bileki/CarPuter/Images/IMG_20160610_152235857_HDR.jpg

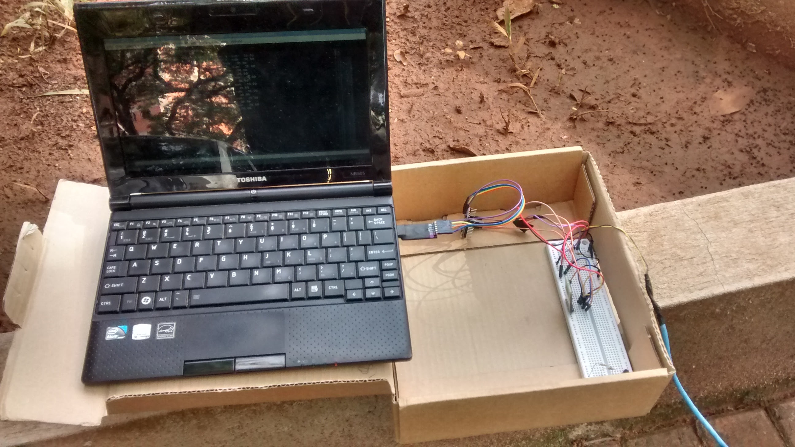
Images/IMG_20160610_152235857_HDR.jpg
