bileki/CarPuter/Images/IMG_20160610_152221243.jpg

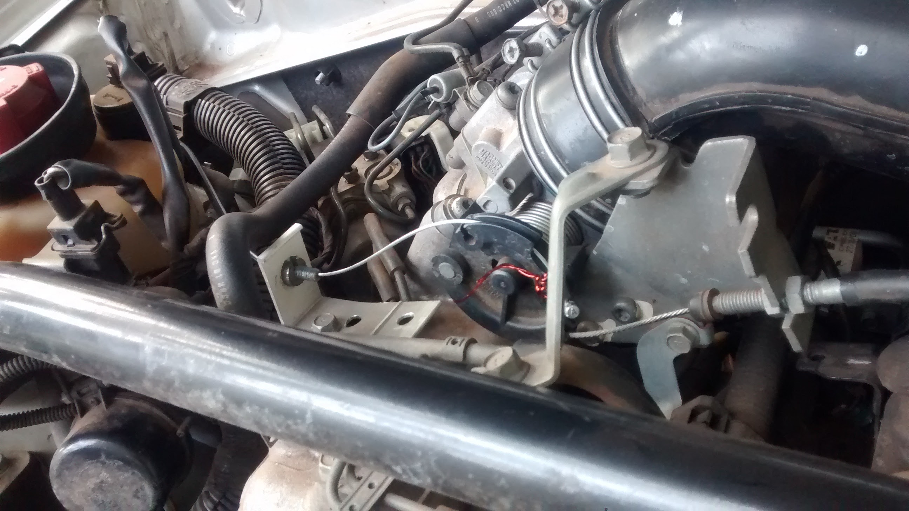
Images/IMG_20160610_152221243.jpg
