bileki/CarPuter/Images/IMG_20160420_165813343.jpg

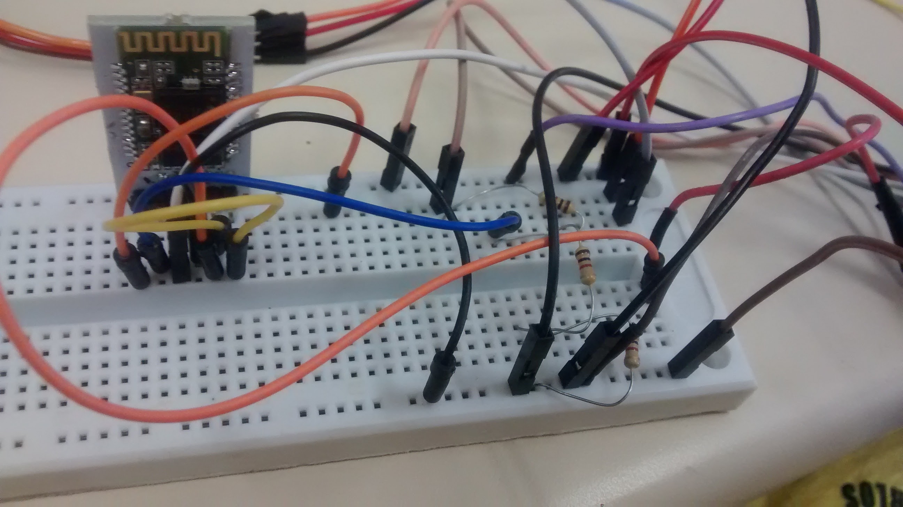
Images/IMG_20160420_165813343.jpg
