bileki/CarPuter/Images/IMG_20160420_165830831.jpg

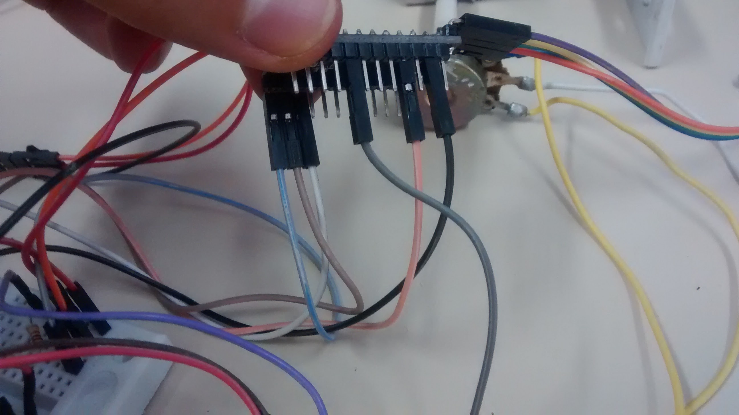
Images/IMG_20160420_165830831.jpg
