bileki/CarPuter/Images/IMG_20160420_165851657.jpg

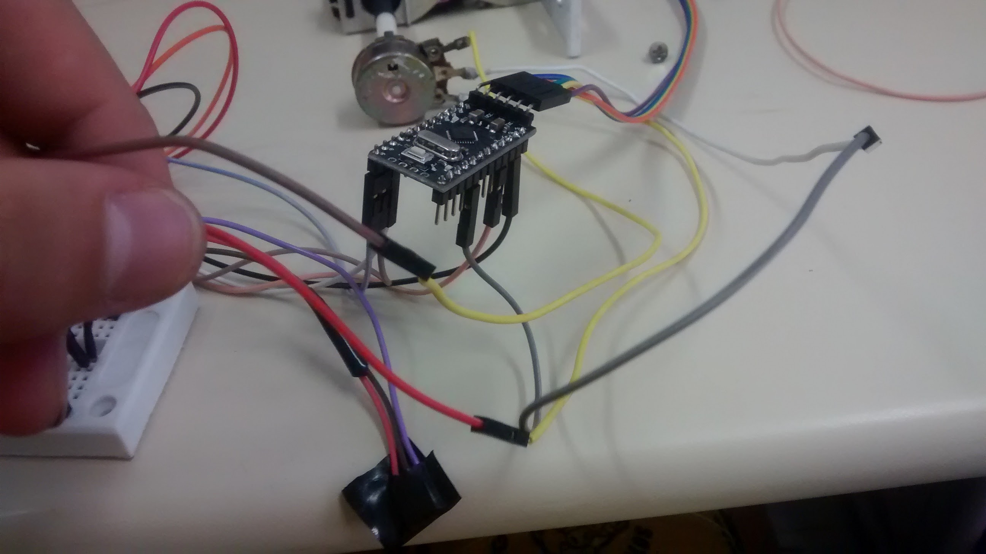
Images/IMG_20160420_165851657.jpg
