bileki/CarPuter/Images/IMG_20160420_165911727.jpg

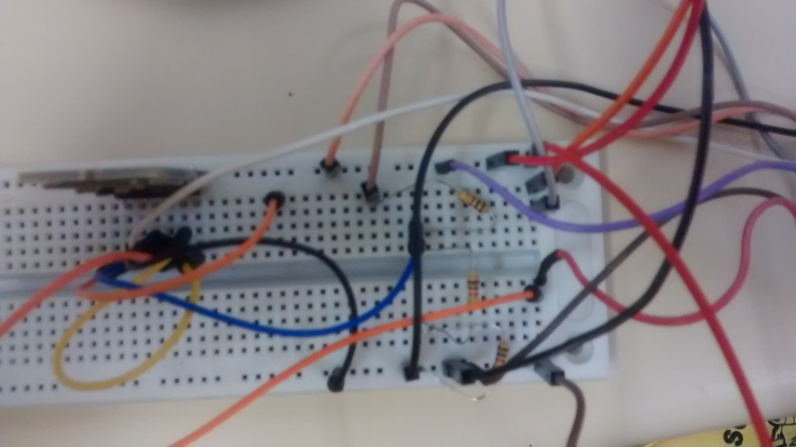
Images/IMG_20160420_165911727.jpg
