bileki/CarPuter/Images/IMG_20160426_163107566.jpg

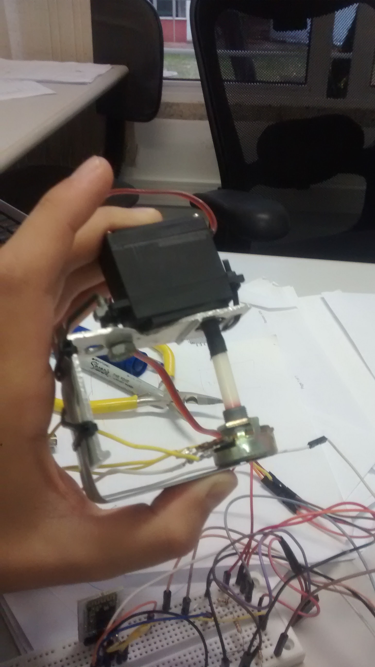
Images/IMG_20160426_163107566.jpg
