bileki/CarPuter/Images/IMG_20160426_163113935.jpg

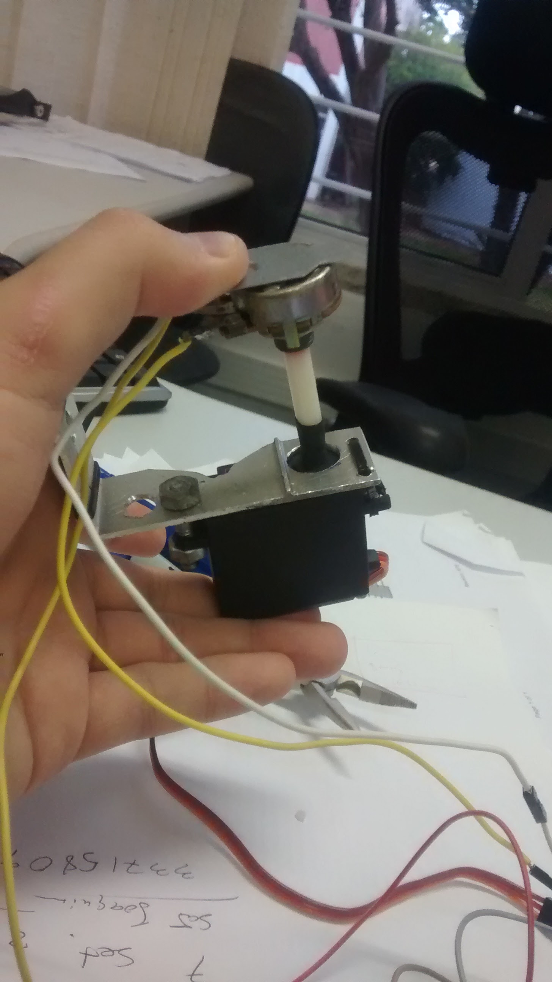
Images/IMG_20160426_163113935.jpg
