bileki/CarPuter/Images/IMG_20160426_163121419.jpg

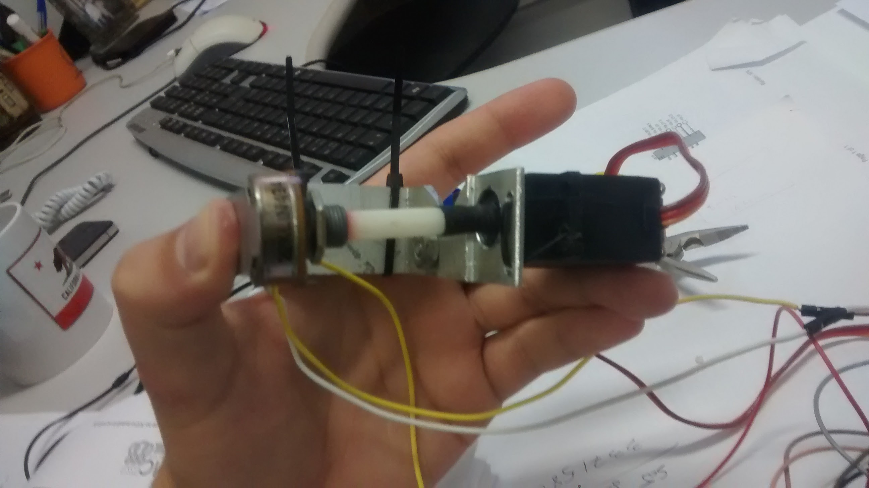
Images/IMG_20160426_163121419.jpg
