bileki/CarPuter/Images/IMG_20160426_163433131_HDR.jpg

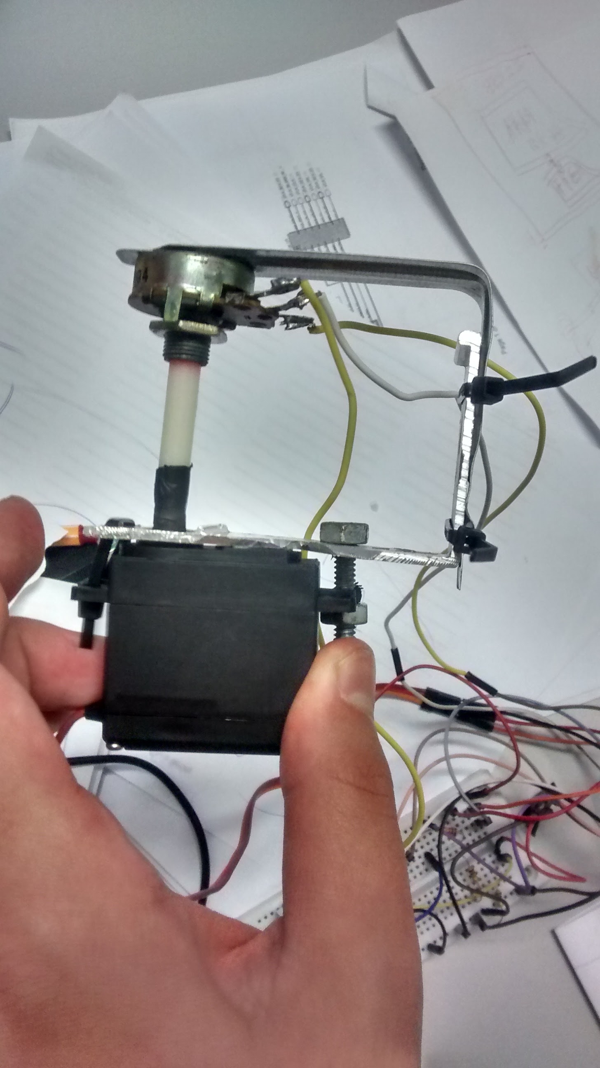
Images/IMG_20160426_163433131_HDR.jpg
