bileki/CarPuter/Images/IMG_20160426_163441426.jpg

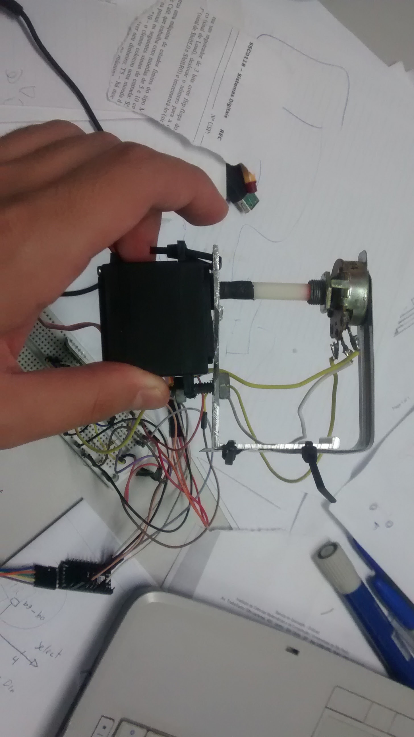
Images/IMG_20160426_163441426.jpg
