bileki/CarPuter/Images/IMG_20160609_145108967_HDR.jpg

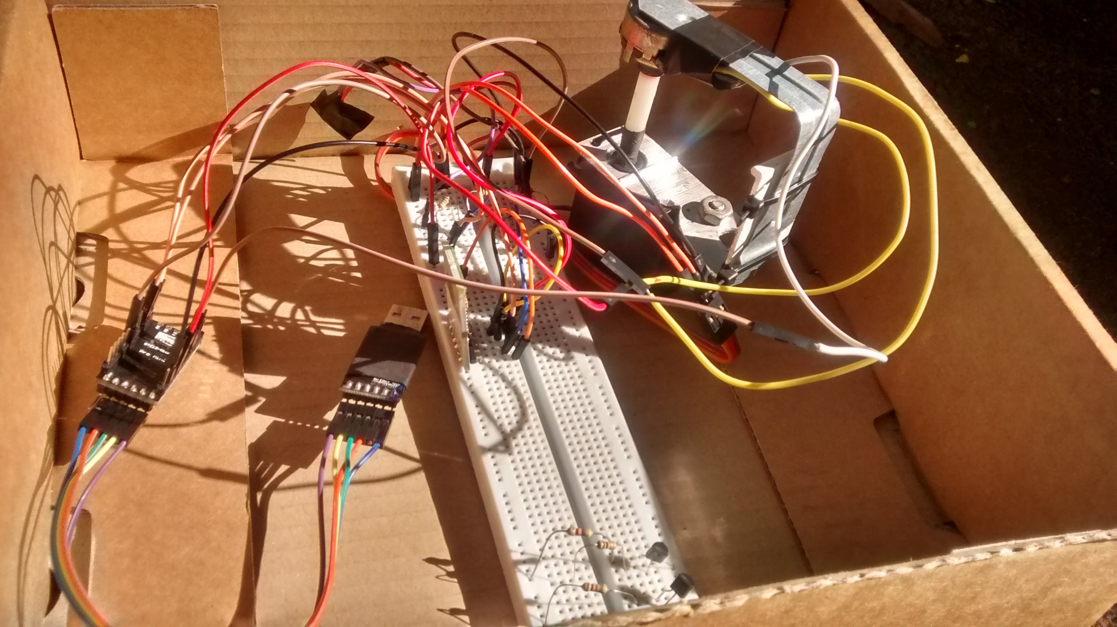
Images/IMG_20160609_145108967_HDR.jpg
