bileki/CarPuter/Images/IMG_20160609_145117136_HDR.jpg

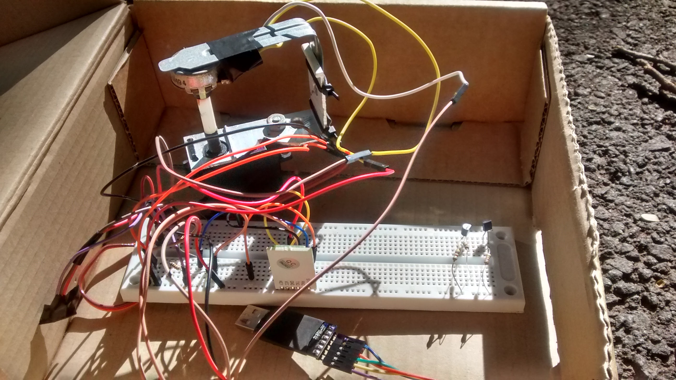
Images/IMG_20160609_145117136_HDR.jpg
