bileki/CarPuter/Images/IMG_20160609_145126340.jpg

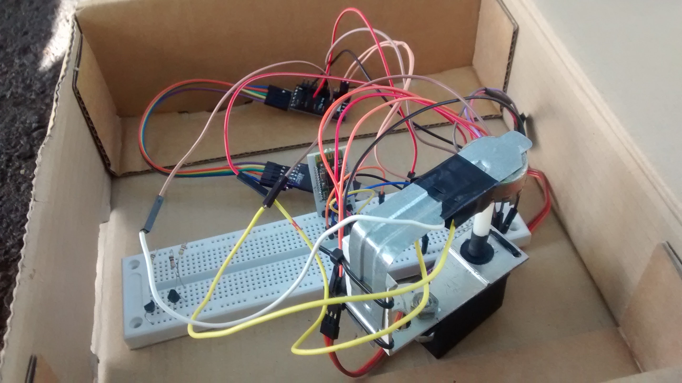
Images/IMG_20160609_145126340.jpg
