bileki/CarPuter/Images/IMG_20160609_145140546.jpg

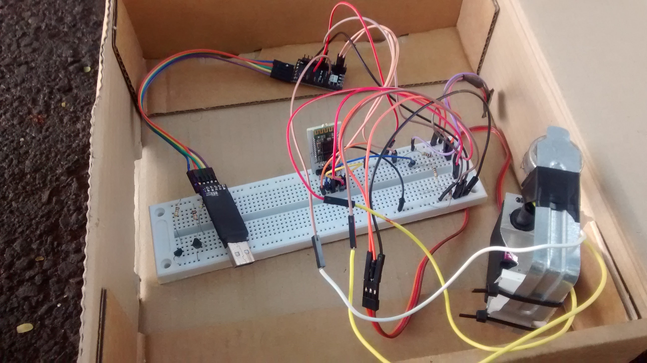
Images/IMG_20160609_145140546.jpg
