bileki/CarPuter/Images/IMG_20160609_145341580.jpg

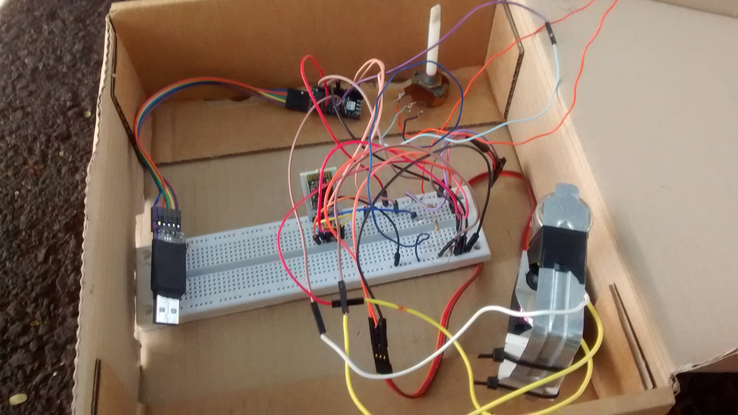
Images/IMG_20160609_145341580.jpg
