bileki/CarPuter/Images/IMG_20160609_145351377.jpg

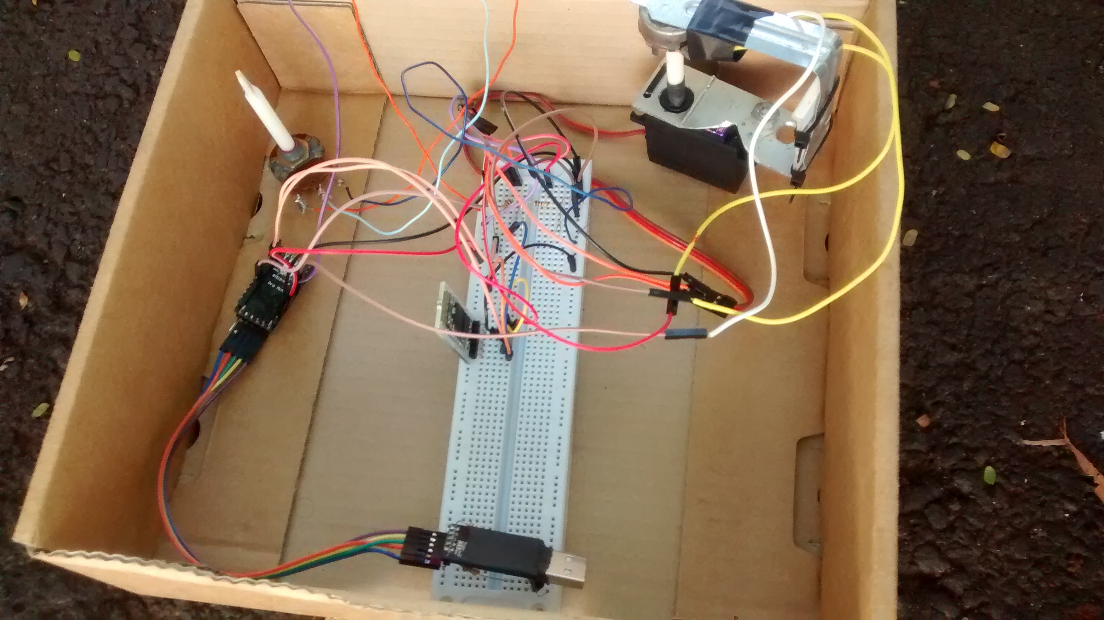
Images/IMG_20160609_145351377.jpg
