bileki/CarPuter/Images/IMG_20160609_145409022.jpg

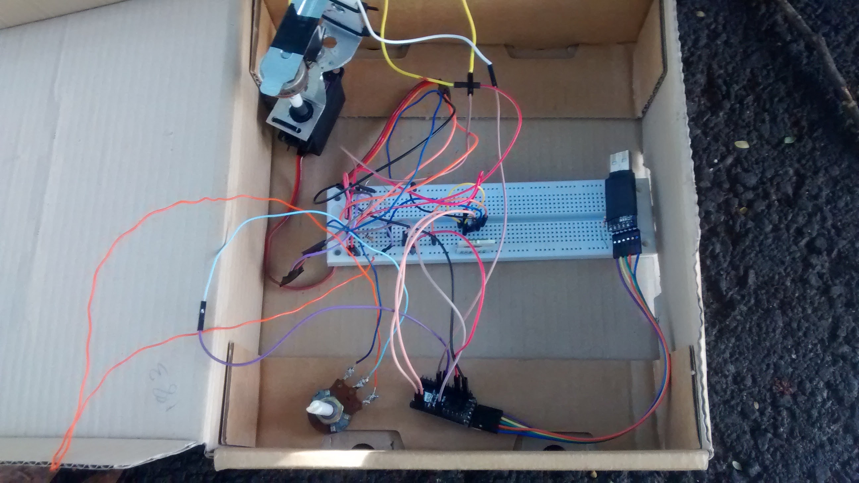
Images/IMG_20160609_145409022.jpg
