bileki/CarPuter/Images/IMG_20160609_145414677.jpg

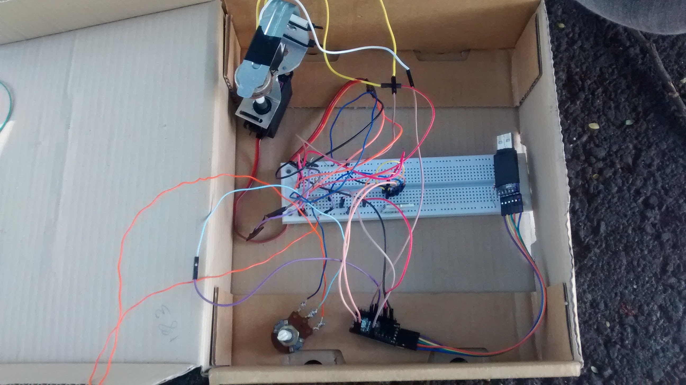
Images/IMG_20160609_145414677.jpg
