bileki/CarPuter/Images/IMG_20160609_145450878.jpg

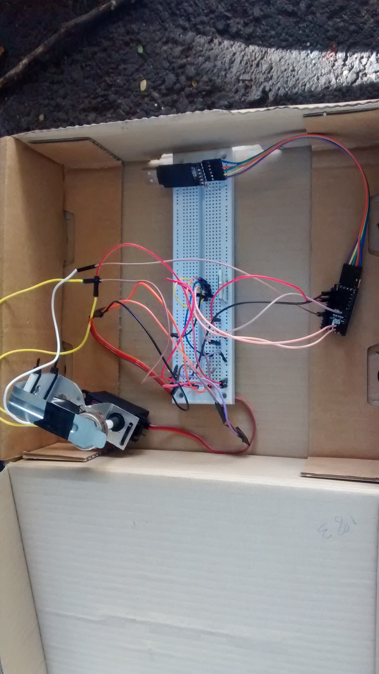
Images/IMG_20160609_145450878.jpg
