bileki/CarPuter/Images/IMG_20160609_145453415.jpg

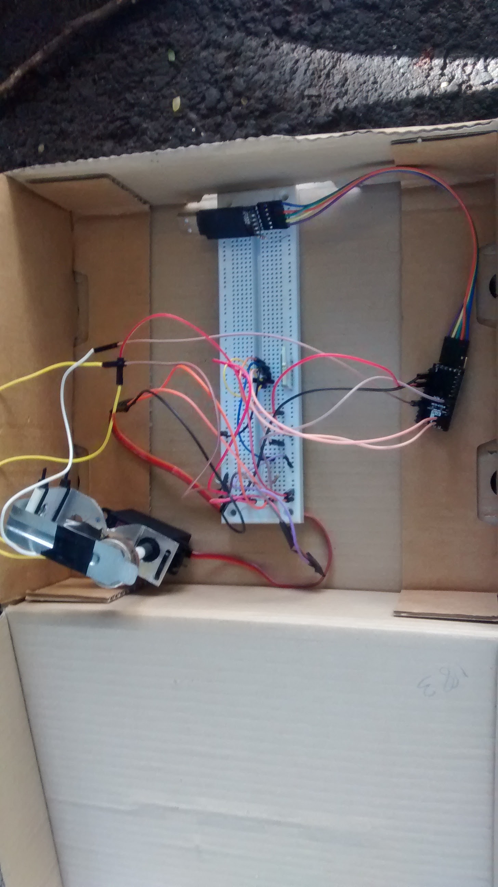
Images/IMG_20160609_145453415.jpg
