bileki/CarPuter/Images/IMG_20160609_145530211.jpg

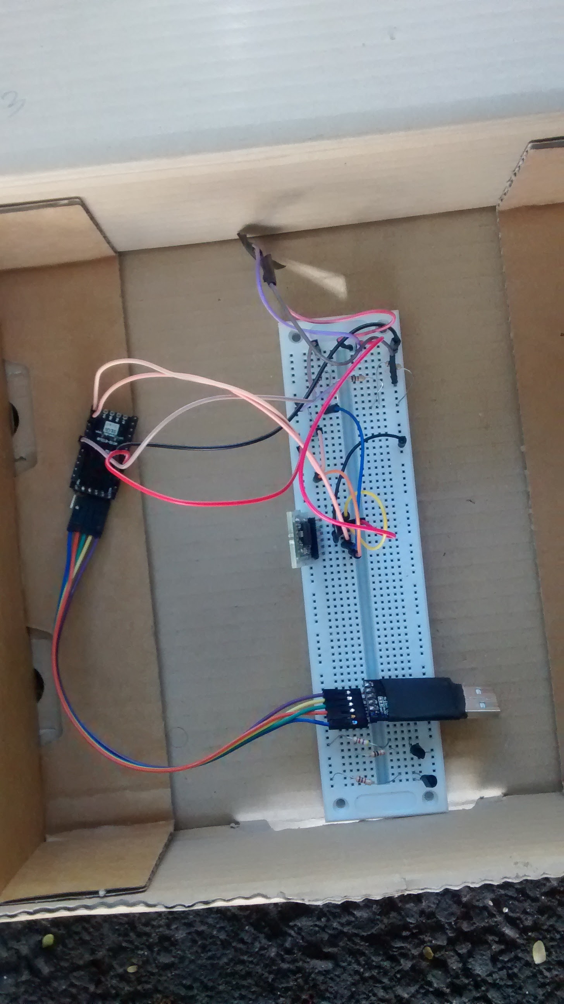
Images/IMG_20160609_145530211.jpg
