bileki/CarPuter/Images/IMG_20160609_145536437.jpg

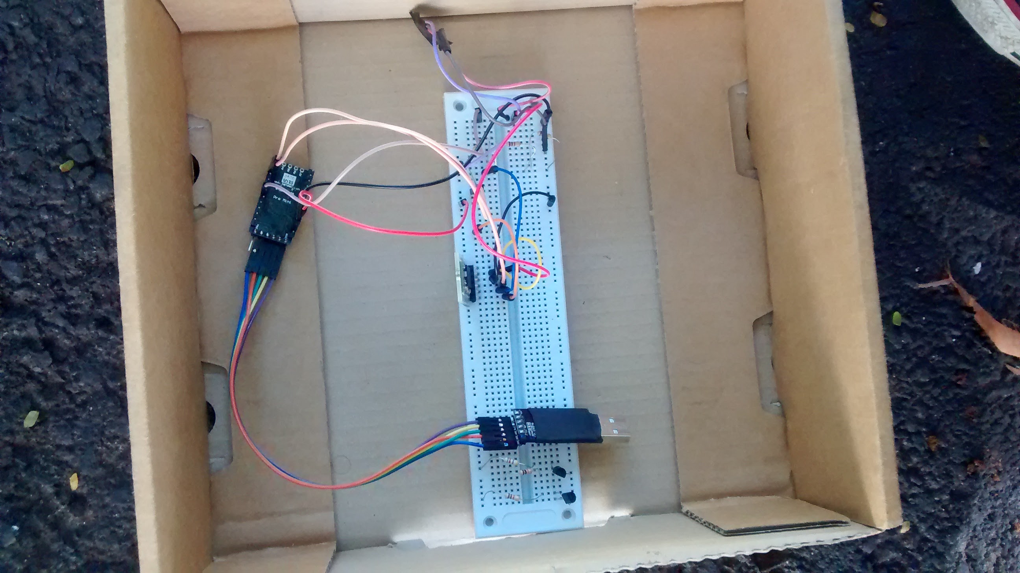
Images/IMG_20160609_145536437.jpg
