bileki/CarPuter/Images/IMG_20160609_145542285.jpg

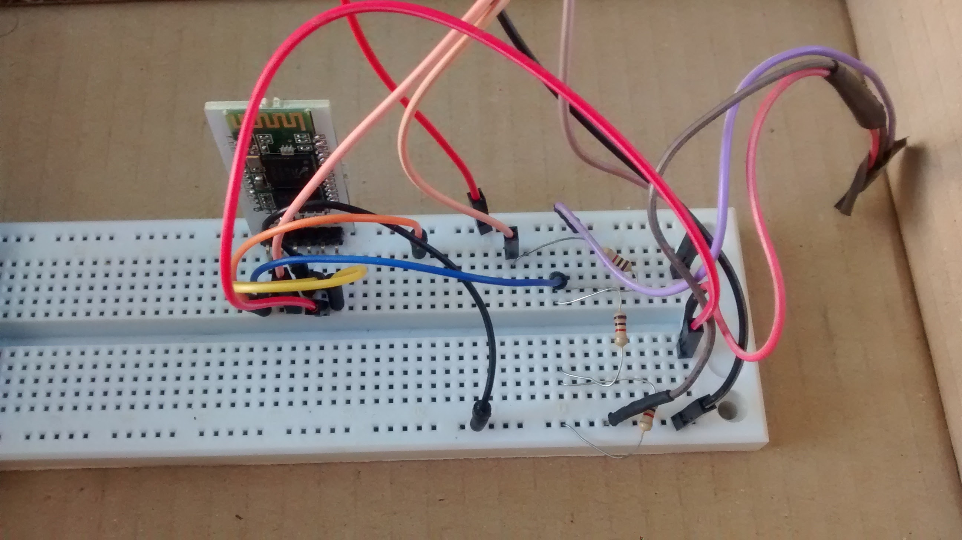
Images/IMG_20160609_145542285.jpg
