bileki/CarPuter/Images/IMG_20160609_145554885.jpg

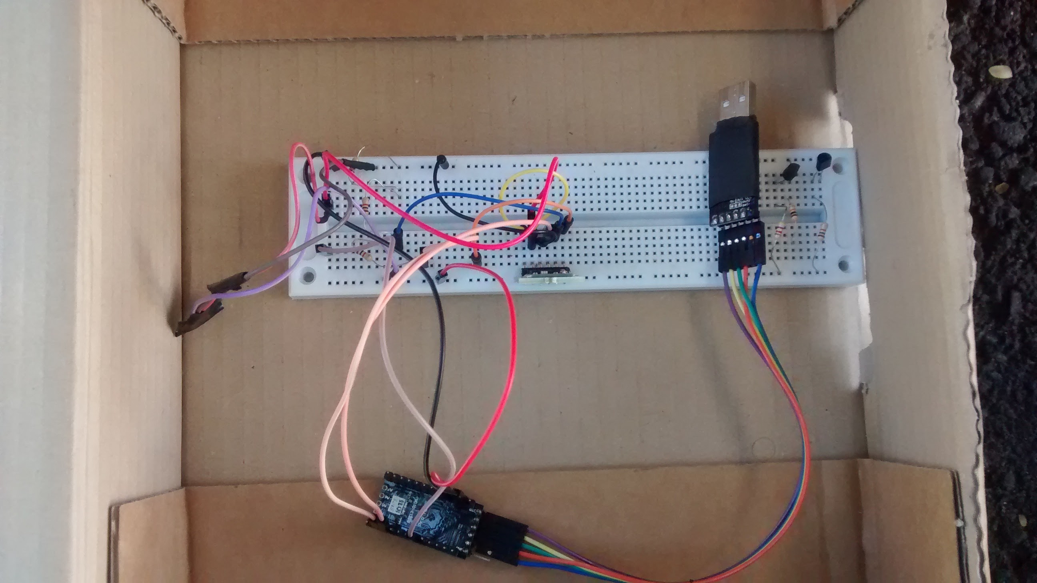
Images/IMG_20160609_145554885.jpg
