bileki/CarPuter/Images/IMG_20160609_145623713.jpg

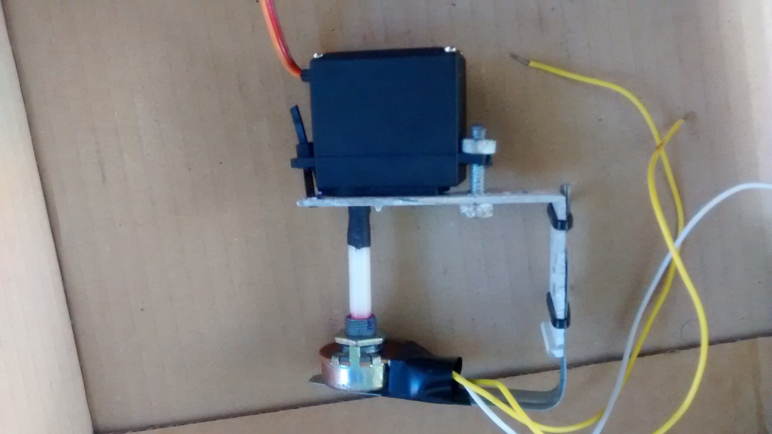
Images/IMG_20160609_145623713.jpg
