bileki/CarPuter/Images/IMG_20160609_145633164.jpg

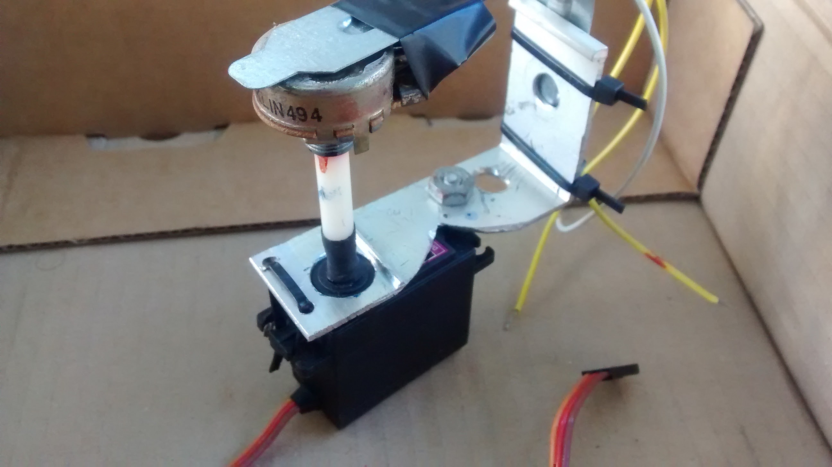
Images/IMG_20160609_145633164.jpg
