bileki/CarPuter/Images/IMG_20160609_145637357.jpg

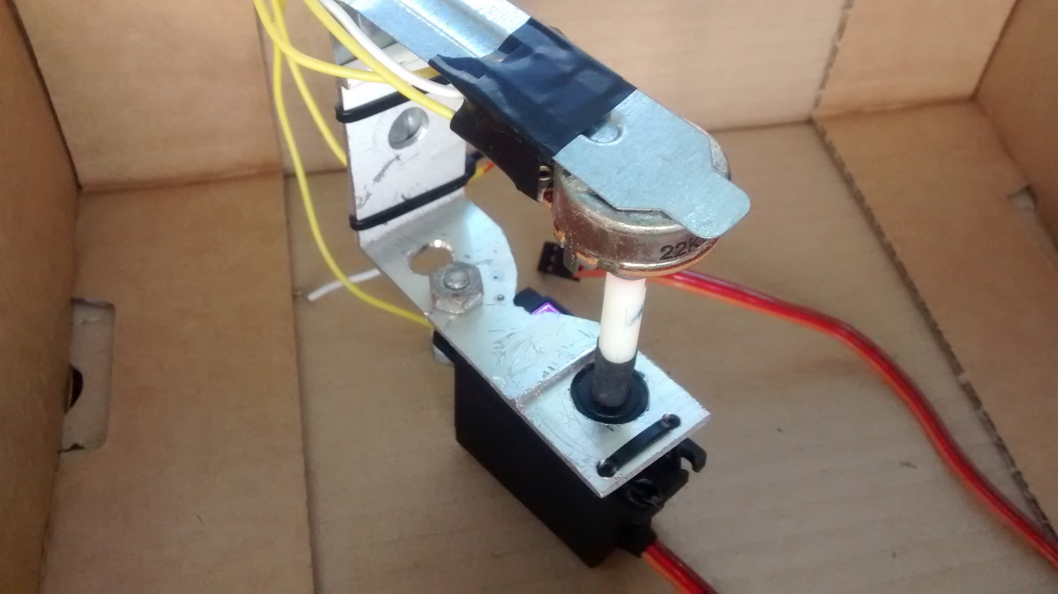
Images/IMG_20160609_145637357.jpg
