bileki/CarPuter/Images/IMG_20160609_150222670_HDR.jpg

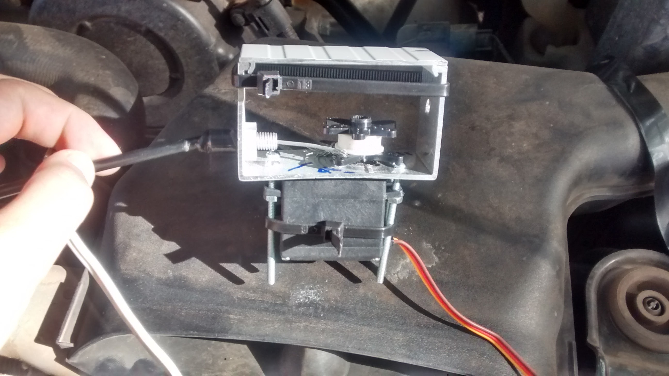
Images/IMG_20160609_150222670_HDR.jpg
