bileki/CarPuter/Images/IMG_20160609_150231308_HDR.jpg

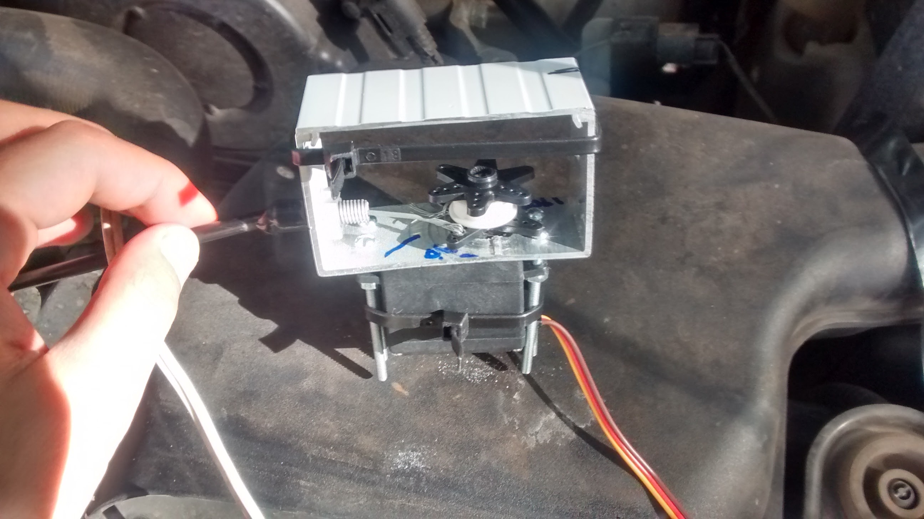
Images/IMG_20160609_150231308_HDR.jpg
