bileki/CarPuter/Images/IMG_20160609_150238756.jpg

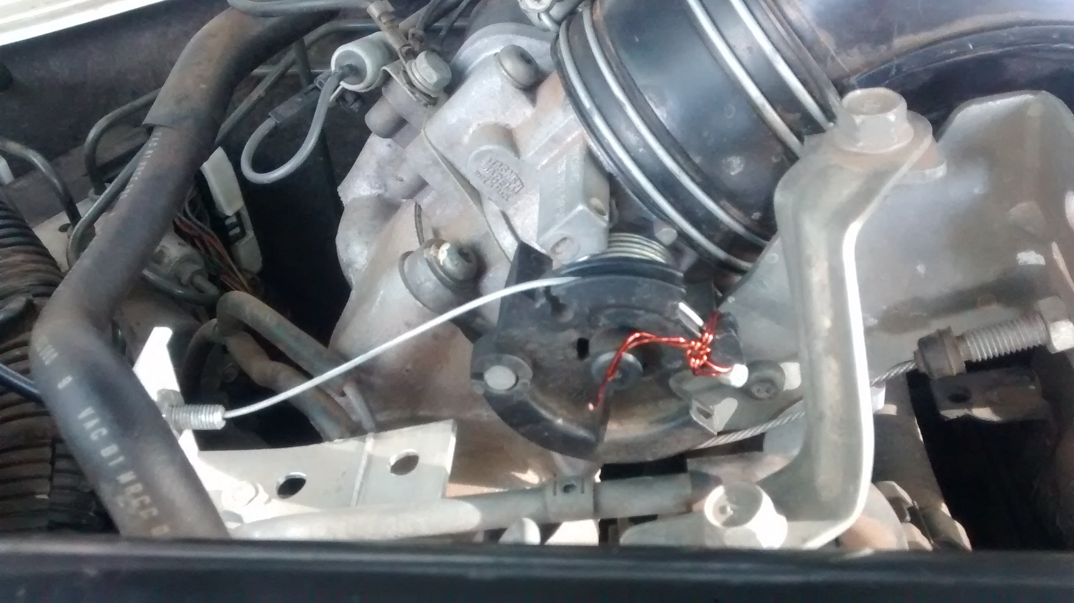
Images/IMG_20160609_150238756.jpg
