bileki/CarPuter/Images/IMG_20160610_152211981.jpg

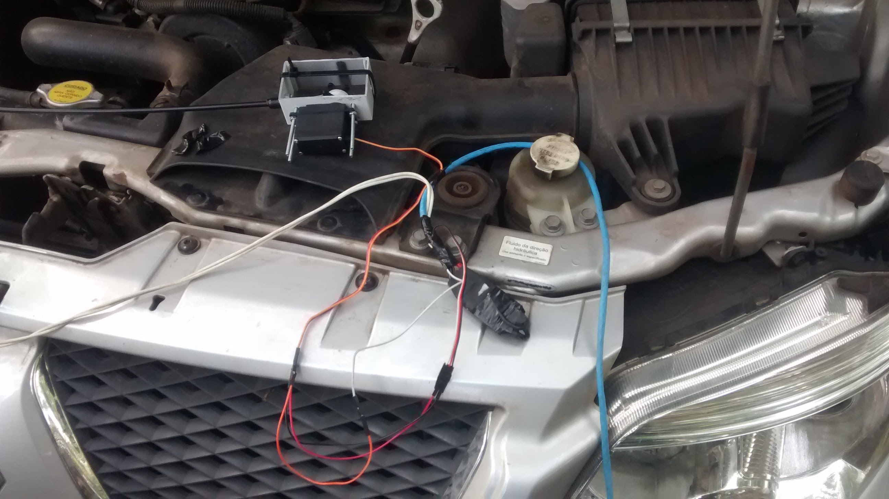
Images/IMG_20160610_152211981.jpg
