bileki/CarPuter/Images/IMG_20160610_152216820.jpg

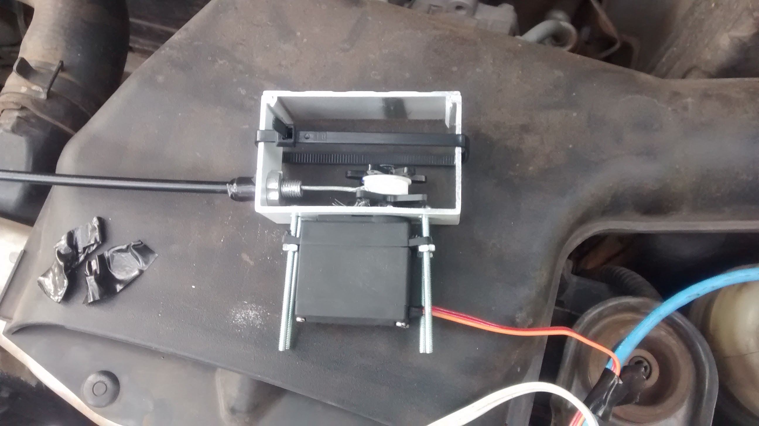
Images/IMG_20160610_152216820.jpg
