bileki/CarPuter/Images/IMG_20160610_152230146_HDR.jpg

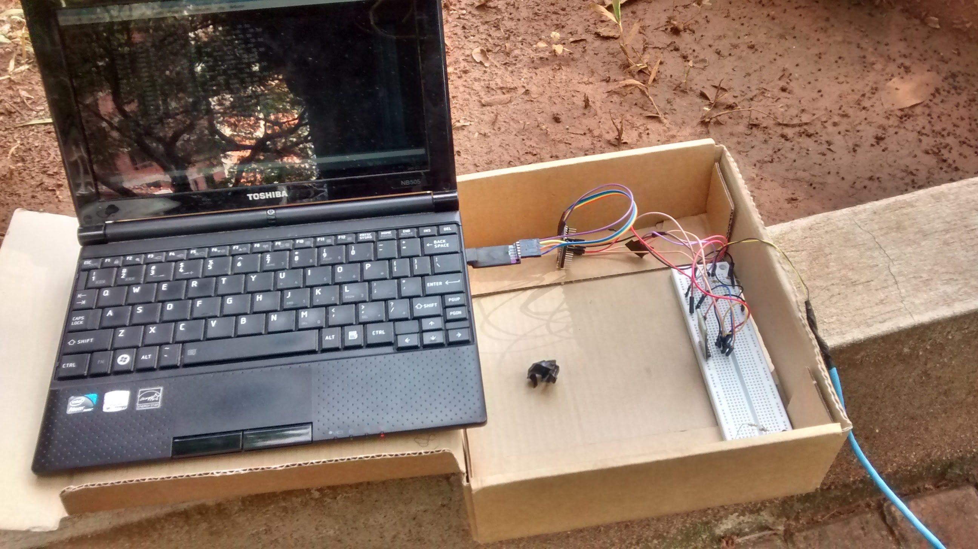
Images/IMG_20160610_152230146_HDR.jpg
