bileki/CarPuter/Images/IMG_20160610_152239870.jpg

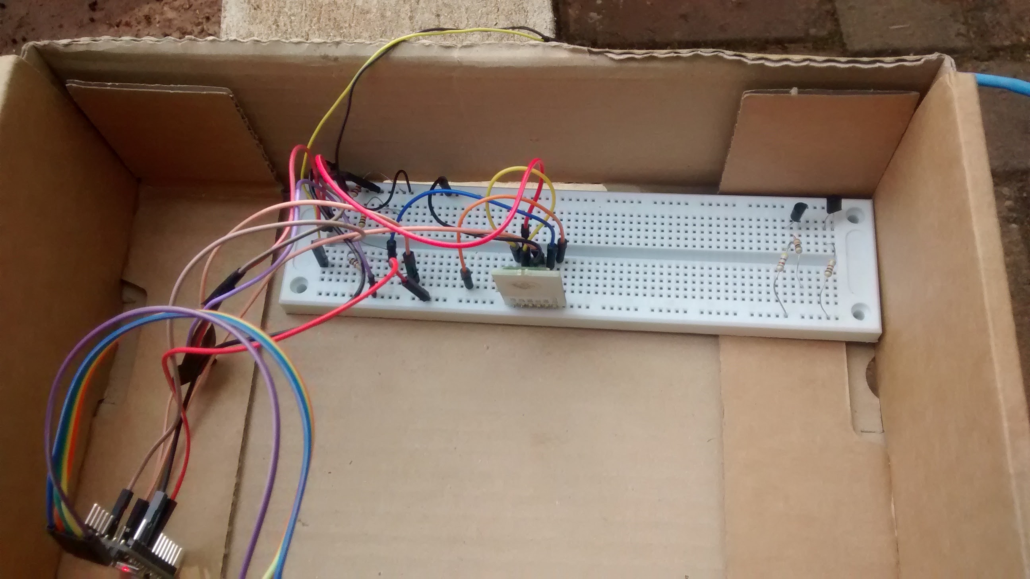
Images/IMG_20160610_152239870.jpg
