bileki/CarPuter/Images/IMG_20160610_152251308.jpg

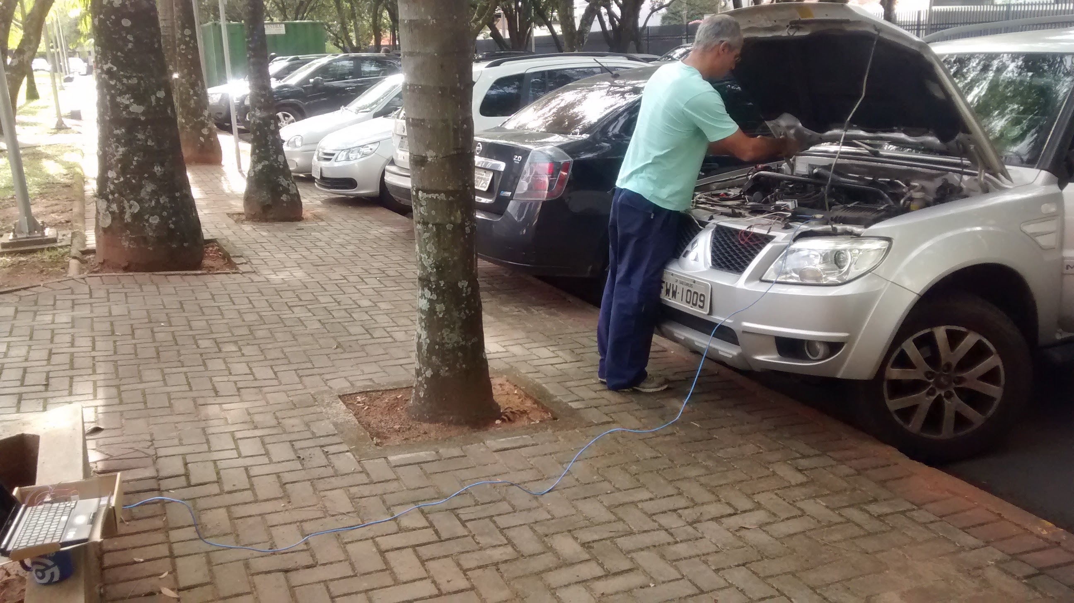
Images/IMG_20160610_152251308.jpg
