bileki/CarPuter/Images/PhotosSpeedControllerMitsubishi/IMG_2690.JPG

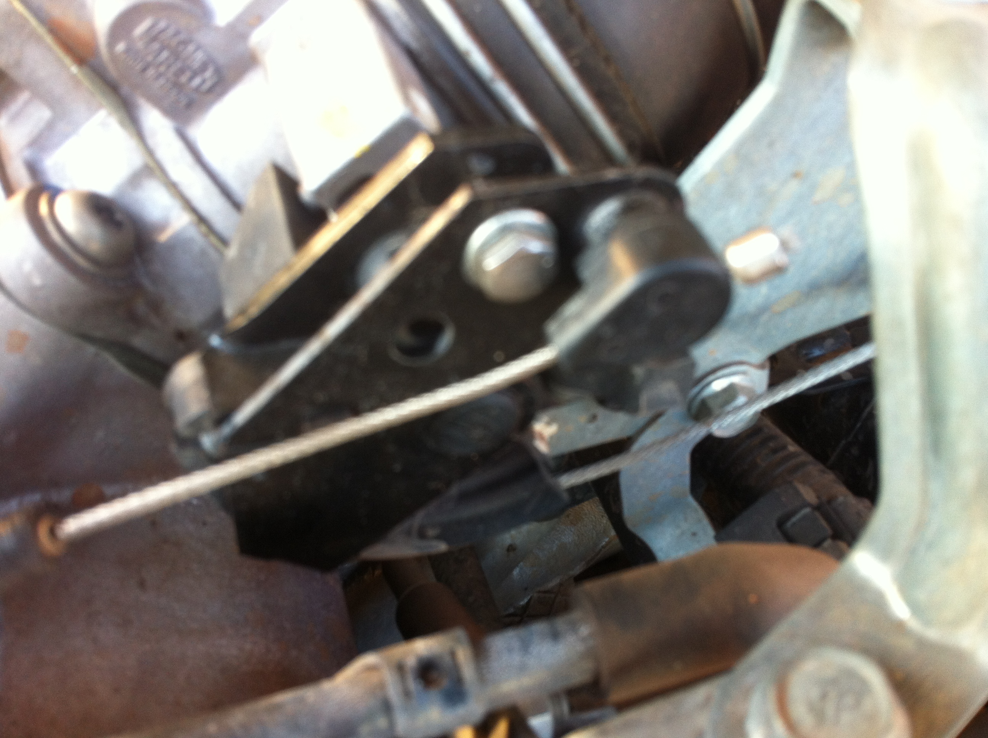
Images/PhotosSpeedControllerMitsubishi/IMG_2690.JPG
