bileki/CarPuter/Images/PhotosSpeedControllerMitsubishi/IMG_2691.JPG

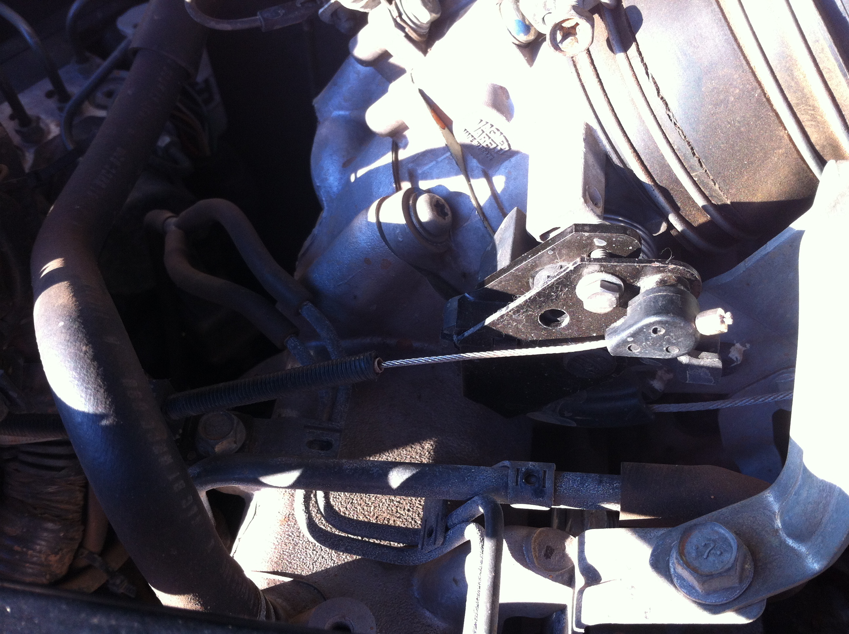
Images/PhotosSpeedControllerMitsubishi/IMG_2691.JPG
