bileki/CarPuter/Images/PhotosSpeedControllerMitsubishi/IMG_2692.JPG

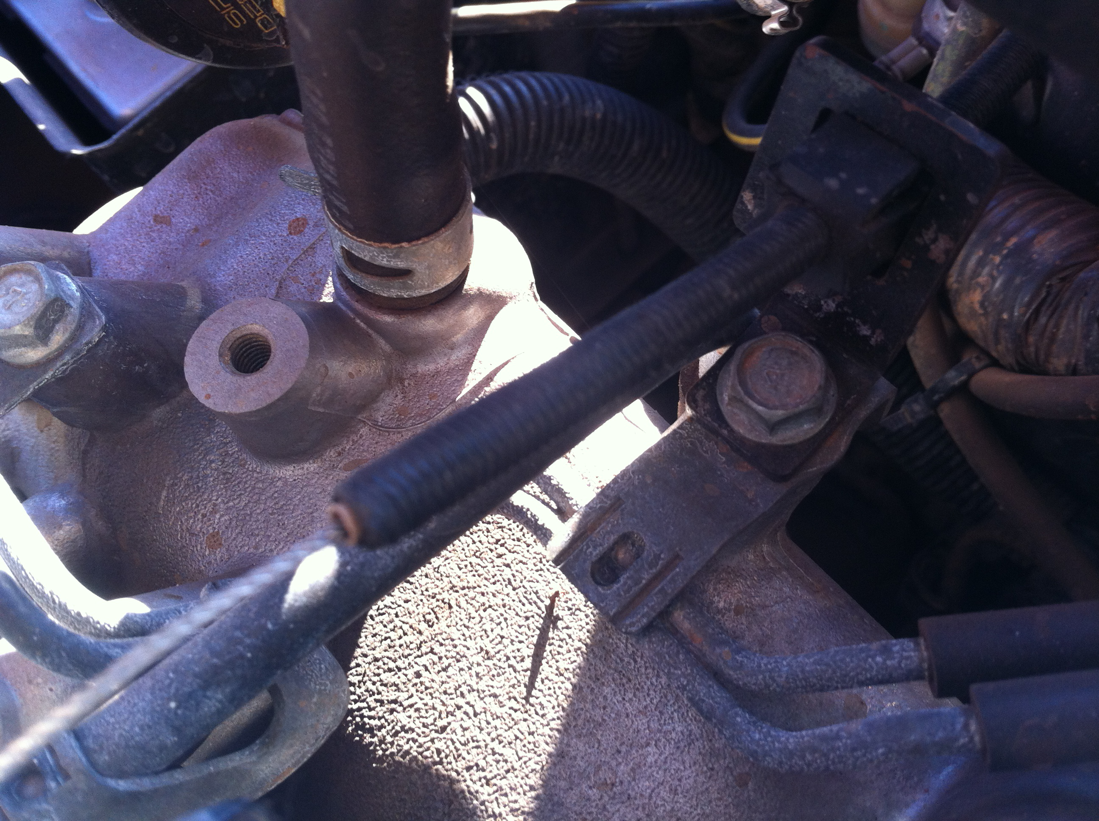
Images/PhotosSpeedControllerMitsubishi/IMG_2692.JPG
