bileki/CarPuter/Images/PhotosSpeedControllerMitsubishi/IMG_2693.JPG

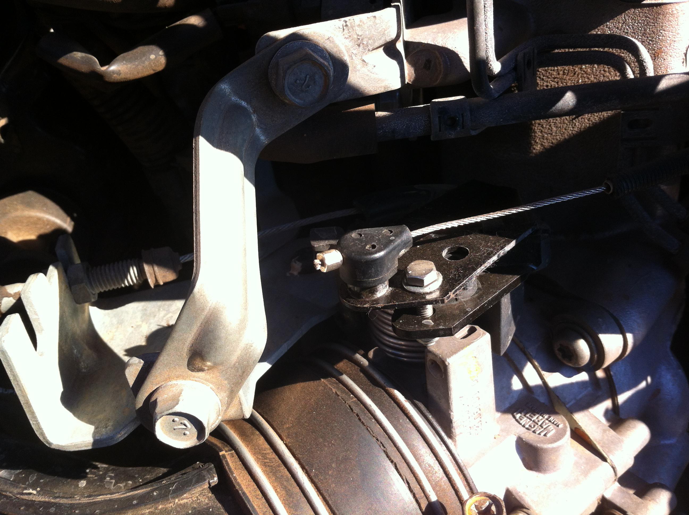
Images/PhotosSpeedControllerMitsubishi/IMG_2693.JPG
