bileki/CarPuter/Images/PhotosSpeedControllerMitsubishi/IMG_2694.JPG

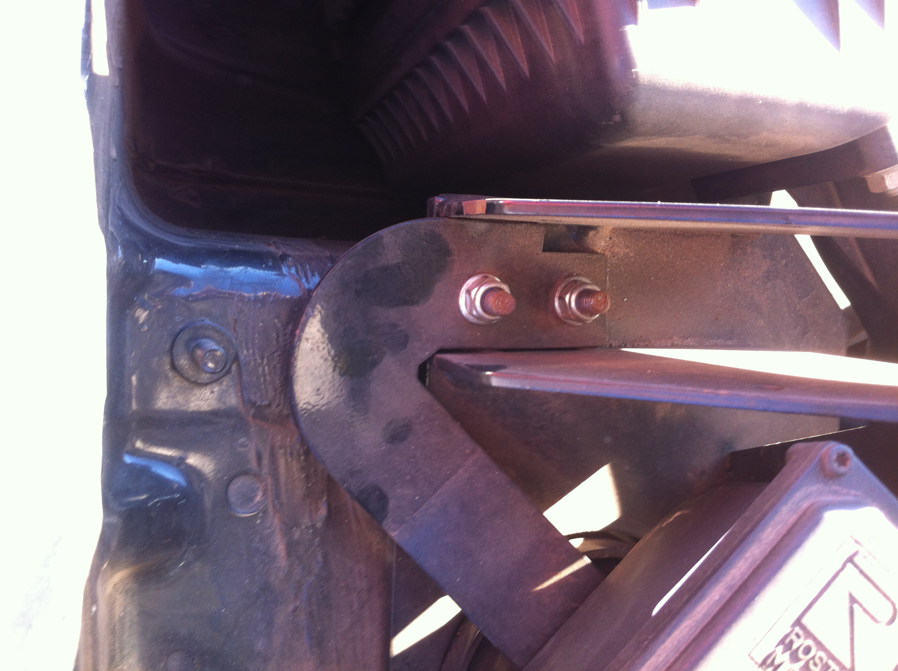
Images/PhotosSpeedControllerMitsubishi/IMG_2694.JPG
