bileki/CarPuter/Images/PhotosSpeedControllerMitsubishi/IMG_2695.JPG

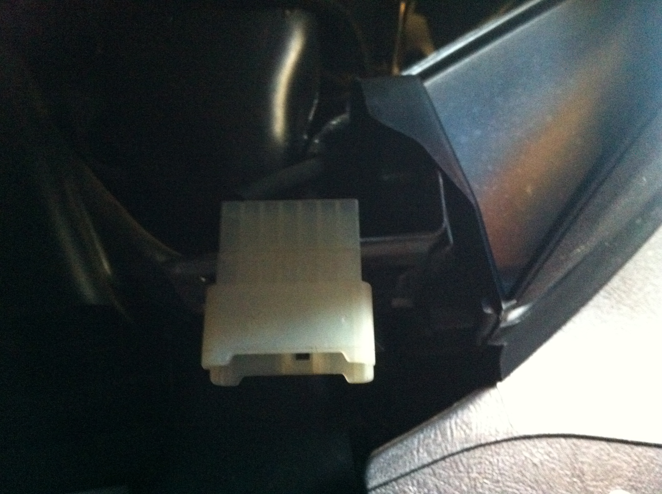
Images/PhotosSpeedControllerMitsubishi/IMG_2695.JPG
