bileki/CarPuter/Images/PhotosSpeedControllerMitsubishi/IMG_2696.JPG

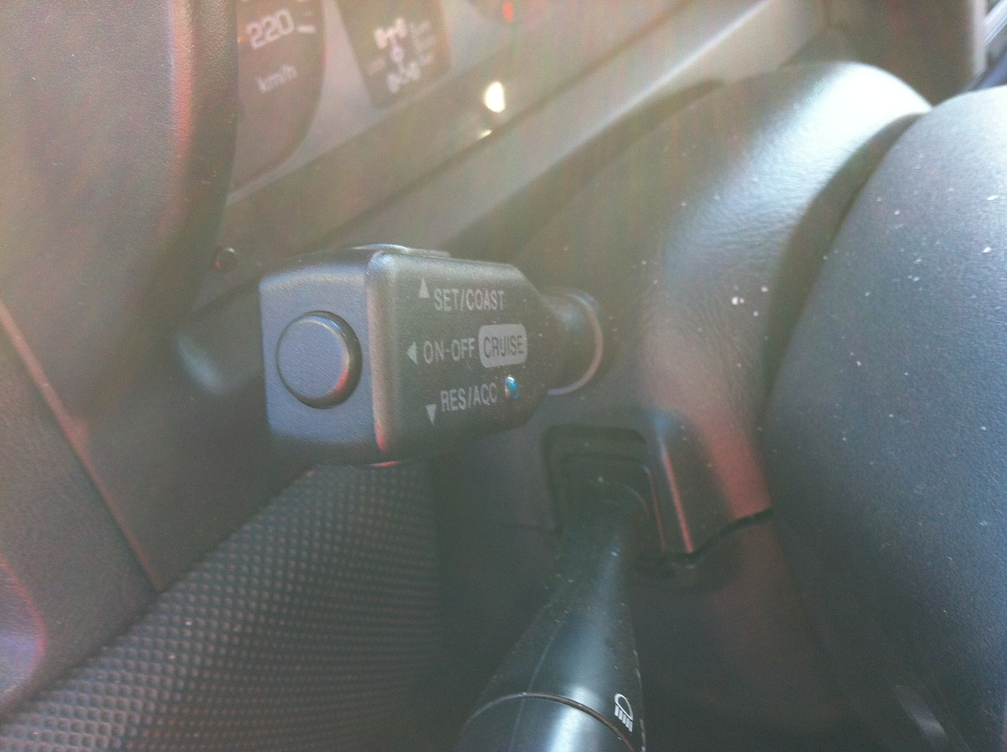
Images/PhotosSpeedControllerMitsubishi/IMG_2696.JPG
