bileki/CarPuter/CarData/teste10estradakp2.txt

[SEND] sair
t: 0	 tv: 0	 rpm: 831	 v: 14	 vb: 1	 pwm: 20	 sum: -17.78
t: 0	 tv: 0	 rpm: 837	 v: 14	 vb: 1	 pwm: 20	 sum: -29.29
t: 0	 tv: 0	 rpm: 838	 v: 14	 vb: 1	 pwm: 20	 sum: -30.00
t: 0	 tv: 0	 rpm: 836	 v: 14	 vb: 1	 pwm: 20	 sum: -30.00
t: 0	 tv: 0	 rpm: 827	 v: 14	 vb: 1	 pwm: 20	 sum: -30.00
t: 0	 tv: 0	 rpm: 828	 v: 14	 vb: 1	 pwm: 20	 sum: -30.00
t: 0	 tv: 0	 rpm: 830	 v: 14	 vb: 1	 pwm: 20	 sum: -30.00
t: 0	 tv: 0	 rpm: 835	 v: 14	 vb: 1	 pwm: 20	 sum: -30.00
t: 0	 tv: 0	 rpm: 834	 v: 14	 vb: 1	 pwm: 20	 sum: -30.00
t: 0	 tv: 0	 rpm: 835	 v: 14	 vb: 1	 pwm: 20	 sum: -30.00
t: 0	 tv: 0	 rpm: 834	 v: 14	 vb: 1	 pwm: 20	 sum: -30.00
t: 0	 tv: 0	 rpm: 822	 v: 14	 vb: 1	 pwm: 20	 sum: -30.00
t: 0	 tv: 0	 rpm: 829	 v: 14	 vb: 1	 pwm: 20	 sum: -30.00
t: 0	 tv: 0	 rpm: 836	 v: 14	 vb: 1	 pwm: 20	 sum: -30.00
t: 0	 tv: 0	 rpm: 831	 v: 14	 vb: 1	 pwm: 20	 sum: -30.00
t: 0	 tv: 0	 rpm: 845	 v: 15	 vb: 1	 pwm: 20	 sum: -30.00
t: 0	 tv: 0	 rpm: 823	 v: 14	 vb: 1	 pwm: 20	 sum: -30.00
t: 0	 tv: 0	 rpm: 819	 v: 14	 vb: 1	 pwm: 20	 sum: -30.00
t: 6	 tv: 0	 rpm: 1265	 v: 22	 vb: 1	 pwm: 20	 sum: 0.00
t: 10	 tv: 0	 rpm: 982	 v: 17	 vb: 1	 pwm: 20	 sum: 0.00
t: 8	 tv: 0	 rpm: 1209	 v: 21	 vb: 1	 pwm: 20	 sum: 0.00
t: 13	 tv: 0	 rpm: 1661	 v: 28	 vb: 1	 pwm: 20	 sum: 0.00
t: 2	 tv: 0	 rpm: 1827	 v: 31	 vb: 1	 pwm: 20	 sum: 0.00
t: 14	 tv: 0	 rpm: 1131	 v: 19	 vb: 1	 pwm: 20	 sum: 0.00
t: 22	 tv: 0	 rpm: 1463	 v: 25	 vb: 1	 pwm: 20	 sum: 0.00
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
t: 0	 tv: 0	 rpm: 832	 v: 14	 vb: 1	 pwm: 20	 sum: -30.00
t: 0	 tv: 0	 rpm: 832	 v: 14	 vb: 1	 pwm: 20	 sum: -30.00
t: 0	 tv: 0	 rpm: 832	 v: 14	 vb: 1	 pwm: 20	 sum: -30.00
t: 0	 tv: 0	 rpm: 832	 v: 14	 vb: 1	 pwm: 20	 sum: -30.00
t: 0	 tv: 0	 rpm: 832	 v: 14	 vb: 1	 pwm: 20	 sum: -30.00
