bileki/CarPuter/CarData/teste11estradakp3.txt

[SEND] sair
t: 0	 tv: 0	 rpm: 838	 v: 14	 vb: 1	 pwm: 20	 sum: -26.75
t: 0	 tv: 0	 rpm: 831	 v: 14	 vb: 1	 pwm: 20	 sum: -30.00
t: 0	 tv: 0	 rpm: 841	 v: 15	 vb: 1	 pwm: 20	 sum: -30.00
t: 0	 tv: 0	 rpm: 828	 v: 14	 vb: 1	 pwm: 20	 sum: -30.00
t: 0	 tv: 0	 rpm: 838	 v: 14	 vb: 1	 pwm: 20	 sum: -30.00
t: 0	 tv: 0	 rpm: 848	 v: 15	 vb: 1	 pwm: 20	 sum: -30.00
t: 0	 tv: 0	 rpm: 833	 v: 14	 vb: 1	 pwm: 20	 sum: -30.00
t: 0	 tv: 0	 rpm: 841	 v: 15	 vb: 1	 pwm: 20	 sum: -30.00
t: 0	 tv: 0	 rpm: 820	 v: 14	 vb: 1	 pwm: 20	 sum: -30.00
t: 0	 tv: 0	 rpm: 759	 v: 13	 vb: 1	 pwm: 20	 sum: -30.00
t: 3	 tv: 0	 rpm: 1252	 v: 21	 vb: 1	 pwm: 20	 sum: 0.00
t: 0	 tv: 0	 rpm: 964	 v: 17	 vb: 1	 pwm: 20	 sum: 0.00
t: 0	 tv: 0	 rpm: 1031	 v: 18	 vb: 1	 pwm: 20	 sum: 0.00
t: 0	 tv: 0	 rpm: 1148	 v: 20	 vb: 1	 pwm: 20	 sum: 0.00
t: 0	 tv: 0	 rpm: 1282	 v: 22	 vb: 1	 pwm: 20	 sum: 0.00
t: 0	 tv: 0	 rpm: 1514	 v: 26	 vb: 1	 pwm: 20	 sum: 0.00
t: 0	 tv: 0	 rpm: 1508	 v: 26	 vb: 1	 pwm: 20	 sum: 0.00
t: 0	 tv: 0	 rpm: 1266	 v: 22	 vb: 1	 pwm: 20	 sum: 0.00
t: 0	 tv: 0	 rpm: 1204	 v: 21	 vb: 1	 pwm: 20	 sum: 0.00
t: 0	 tv: 0	 rpm: 1467	 v: 25	 vb: 1	 pwm: 20	 sum: 0.00
t: 0	 tv: 0	 rpm: 1105	 v: 19	 vb: 1	 pwm: 20	 sum: 0.00
t: 0	 tv: 0	 rpm: 1076	 v: 18	 vb: 1	 pwm: 20	 sum: 0.00
t: 5	 tv: 0	 rpm: 1212	 v: 21	 vb: 1	 pwm: 20	 sum: 0.00
t: 13	 tv: 0	 rpm: 1637	 v: 28	 vb: 1	 pwm: 20	 sum: 0.00
t: 22	 tv: 0	 rpm: 2499	 v: 42	 vb: 1	 pwm: 20	 sum: 0.00
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
t: 0	 tv: 0	 rpm: 1088	 v: 19	 vb: 1	 pwm: 20	 sum: 0.00
t: 0	 tv: 0	 rpm: 960	 v: 17	 vb: 1	 pwm: 20	 sum: 0.00
t: 0	 tv: 0	 rpm: 896	 v: 15	 vb: 1	 pwm: 20	 sum: -9.08
t: 0	 tv: 0	 rpm: 896	 v: 15	 vb: 1	 pwm: 20	 sum: -18.15
t: 0	 tv: 0	 rpm: 960	 v: 17	 vb: 1	 pwm: 20	 sum: 0.00
