bileki/CarPuter/CarData/teste14estradaIAheuristica.txt

[SEND] sair
t: 0	 tv: 0	 rpm: 823	 v: 14	 vb: 1	 pwm: 20	 sum: -30.00
t: 0	 tv: 0	 rpm: 819	 v: 14	 vb: 1	 pwm: 20	 sum: -30.00
t: 0	 tv: 0	 rpm: 823	 v: 14	 vb: 1	 pwm: 20	 sum: -30.00
t: 0	 tv: 0	 rpm: 819	 v: 14	 vb: 1	 pwm: 20	 sum: -30.00
t: 0	 tv: 0	 rpm: 819	 v: 14	 vb: 1	 pwm: 20	 sum: -30.00
t: 0	 tv: 0	 rpm: 823	 v: 14	 vb: 1	 pwm: 20	 sum: -30.00
t: 0	 tv: 0	 rpm: 823	 v: 14	 vb: 1	 pwm: 20	 sum: -30.00
t: 0	 tv: 0	 rpm: 809	 v: 14	 vb: 1	 pwm: 20	 sum: -30.00
t: 0	 tv: 0	 rpm: 813	 v: 14	 vb: 1	 pwm: 20	 sum: -30.00
t: 0	 tv: 0	 rpm: 807	 v: 14	 vb: 1	 pwm: 20	 sum: -30.00
t: 0	 tv: 0	 rpm: 848	 v: 15	 vb: 1	 pwm: 20	 sum: -30.00
t: 5	 tv: 0	 rpm: 1186	 v: 20	 vb: 1	 pwm: 20	 sum: 0.00
t: 8	 tv: 0	 rpm: 1620	 v: 28	 vb: 1	 pwm: 20	 sum: 0.00
t: 21	 tv: 0	 rpm: 2246	 v: 38	 vb: 1	 pwm: 20	 sum: 0.00
t: 3	 tv: 0	 rpm: 1640	 v: 28	 vb: 1	 pwm: 20	 sum: 0.00
t: 29	 tv: 0	 rpm: 1890	 v: 32	 vb: 1	 pwm: 20	 sum: 0.00
t: 37	 tv: 0	 rpm: 2369	 v: 40	 vb: 1	 pwm: 20	 sum: 0.00
t: 45	 tv: 0	 rpm: 2898	 v: 49	 vb: 1	 pwm: 20	 sum: 0.00
t: 51	 tv: 0	 rpm: 3416	 v: 57	 vb: 1	 pwm: 20	 sum: 0.00
t: 0	 tv: 0	 rpm: 2793	 v: 47	 vb: 1	 pwm: 20	 sum: 0.00
t: 42	 tv: 0	 rpm: 2530	 v: 43	 vb: 1	 pwm: 20	 sum: 0.00
t: 41	 tv: 0	 rpm: 2752	 v: 46	 vb: 1	 pwm: 20	 sum: 0.00
t: 44	 tv: 0	 rpm: 2970	 v: 50	 vb: 1	 pwm: 20	 sum: 0.00
t: 47	 tv: 0	 rpm: 3150	 v: 53	 vb: 1	 pwm: 20	 sum: 0.00
t: 55	 tv: 0	 rpm: 3350	 v: 56	 vb: 1	 pwm: 20	 sum: 0.00
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
t: 0	 tv: 0	 rpm: 2368	 v: 40	 vb: 1	 pwm: 20	 sum: 0.00
t: 0	 tv: 0	 rpm: 2368	 v: 40	 vb: 1	 pwm: 20	 sum: 0.00
t: 0	 tv: 0	 rpm: 2304	 v: 39	 vb: 1	 pwm: 20	 sum: 0.00
t: 0	 tv: 0	 rpm: 2304	 v: 39	 vb: 1	 pwm: 20	 sum: 0.00
t: 0	 tv: 0	 rpm: 2304	 v: 39	 vb: 1	 pwm: 20	 sum: 0.00
