bileki/CarPuter/SoftwareArduino/testeIA1/testeIA1.ino

  #include <PWM.h> 
  #include <SoftwareSerial.h>
  
  #define LASTERRORINI 100000
  #define LIMTOP -10
  #define LIMDOWN 5
  #define LIMDELTA 100
  #define SUMMAX 10
  #define INTERATIONS 500
  #define TOL 1
  #define TOLACEL 10
  #define TOLKI 25

  float lastProcess = 0;
  float lastError = LASTERRORINI;
  float kp = 0.06, ki = 0.003, kd = 0.0, kb = 0.3;
  float servo = 55, pid;
  float breaker = 0, delta = 0, sum = 0;
  int targetAcel = 70, lasttargetAcel = 70, pwm = 0; 
  int lastThrottle = 0, throttle = 0, throttleMedia = 0;
  int lastSensor = 0, sensor = 0, sensorMedia = 0;
  int countInterations = 0;
  boolean flagBreak = true, flagIA = false, subindo = true;
  int32_t frequency = 50;
  bool success = false;
  
  void setup() {
      InitTimersSafe();      
      // Inicializa serial
      Serial.begin(38400);    
      // Limpa qualquer dado que estiver na serial
      Serial.flush();
      // Define o pino 9 para o PWM do servo
      success = SetPinFrequencySafe(9, frequency); 
      // Inicializa a váriavel de tempo
      lastProcess = millis(); 
  
  }
  
  void loop() {  
      // Lê o valor alvo da serial
    /*  if (Serial.available() > 0) {
          delay(10);
          targetAcel = (Serial.read() - '0') * 100 + (Serial.read() - '0') * 10 + (Serial.read() - '0');
          
          if (targetAcel < 0) 
              targetAcel = 0;
              
          if (targetAcel > 180) 
              targetAcel = 180;      
      }
  */     

      // Lê o valor do potenciômetro usando a média das leituras para evitar ruídos
      throttleMedia = sensorMedia = 0;

      for (int j = 0; j < 100; j++)  {
          sensor = analogRead(A1);
          throttle = analogRead(A0);
          // Mapeia o valor do potenciômetro de 0-1023 para os ângulos de 0-180 
          throttle = map(throttle, 0, 1023, 0, 179);
          sensor = map(sensor, 0, 1023, 70, 160);
          throttleMedia += throttle;
          sensorMedia += sensor;
      }
      throttle = throttleMedia / 100;
      sensor = sensorMedia / 100;

      lasttargetAcel = targetAcel;

      targetAcel = sensor;

      IA();

      // Verifica se o PID será usado
      if (flagIA) {
        // Soma o valor do ângulo atual do servo com a correção do PID
        pid = PID();
        servo += pid;
  
        // Define os limites de rotação do servo
        if (servo > 167)
          servo = 167;
        if (servo < 35)
          servo = 35;
  
        // Zera a soma dos erros integrativos do PID caso a leitura do potenciômetro esteja fora da tolerância
        if ((throttle > (targetAcel + TOLKI)) || (throttle < (targetAcel - TOLKI))) 
          sum = 0;
    
        // Define um intervalo máximo para a soma dos erros integrativos
        if (sum > SUMMAX)
          sum = SUMMAX;
        if (sum < -SUMMAX)
          sum = -SUMMAX;
          
        // Ajusta o valor do servo para inteiro
        pwm = (int)servo;
                        
      } else {
        //================================================================//
        // Desligar o servo e deixar ele ser puxado ou acompanhar o cabo? //
        //================================================================//
        pwm = map(sensor, 60, 170, 35, 167);
      }

      // Define a posição do ângulo do servo
      pwmWrite(9, pwm);

      delay(1);  
  
// Debugging...  
      Serial.print(targetAcel);
      Serial.print("\t");
      Serial.print(throttle);      
      Serial.print("\t");
      Serial.print(pid);
      Serial.print("\t");
      Serial.print(pwm);
      Serial.print("\t");
      Serial.print(sum);
      Serial.print("\t");
      Serial.print(delta);
      Serial.print("\t");
      Serial.print(breaker);
      Serial.print("\t");
      Serial.print(countInterations);
      Serial.print("\t");
      Serial.print(flagIA);
      Serial.print("\t");
      Serial.println();
  }


  void IA() {
    if ((targetAcel < (lasttargetAcel + TOLACEL)) && (targetAcel > (lasttargetAcel - TOLACEL)))
      countInterations++;
    else
      countInterations = 0;

    if (countInterations > INTERATIONS)
      flagIA = true;
    else
      flagIA = false;    
  }

  float PID() {
      float P, I, D, B, myPID, dt, error;
    
      // Cáculo do erro associado as medições
      error = targetAcel - throttle;

      // Cálculo do delta de tempo
      dt = (millis() - lastProcess) / 1000.0;

      // Cálculo da componente proporcional
      P = kp * error;

      // Cálculo da componente integrativa
      sum += (error * dt);
      I = ki * sum;

      // Cálculo da componente derivativa
      // Para evitar divisão por 0 confere-se o dt > 0 e se o lastError é o definido pela primeira vez
      if ((dt > 0) && (lastError != 100000)) {
        delta = ((error - lastError) / dt);
        D = kd * delta;
      }
      else 
        D = delta = 0;

      // Define que o freio não deve ser usado no caso de os sinais da última leitura e da atual forem diferentes(quando a curva muda de sinal), ou se a atual for 0(chegou no setpoint)
      if (((error > 0) && (lastError < 0)) || ((error < 0) && (lastError > 0)) || (error == 0) || (abs(delta) < LIMDELTA))
        flagBreak = false;

      // Define o uso do freio caso o setpoint mudar
      if ((targetAcel != lasttargetAcel))
        flagBreak = true;

      if ((targetAcel - lasttargetAcel) > 0)
        subindo = true;
      if ((targetAcel - lasttargetAcel) < 0)
        subindo = false;


      // Atualiza o último setpoint
      lasttargetAcel = targetAcel;

      // Caso o freio esteja definido pra ser usado e o setpoint não tenha sido alcançado
      if ((flagBreak) && (error != 0))
        if (subindo) breaker = -1 * abs(delta / (error * error));
        else breaker = abs(delta / (error * error));
      else
        breaker = 0;

      // Cálculo da componente do freio
      B = kb * breaker;

      // Define limites de atuação do freio
      if(B > LIMDOWN)
        B = LIMDOWN;
        
      if(B < LIMTOP)
        B = LIMTOP;       
      
      // Atualização dos valores do último erro e tempo
      lastError = error;
      lastProcess  = millis();

      // Resultado do PID
      myPID = P + I + D + B;
      
      return myPID;
  }
